tdorssers/thermostat/schematic/AC.sch

## EAGLE design schematic/AC.sch (2024-11-17)

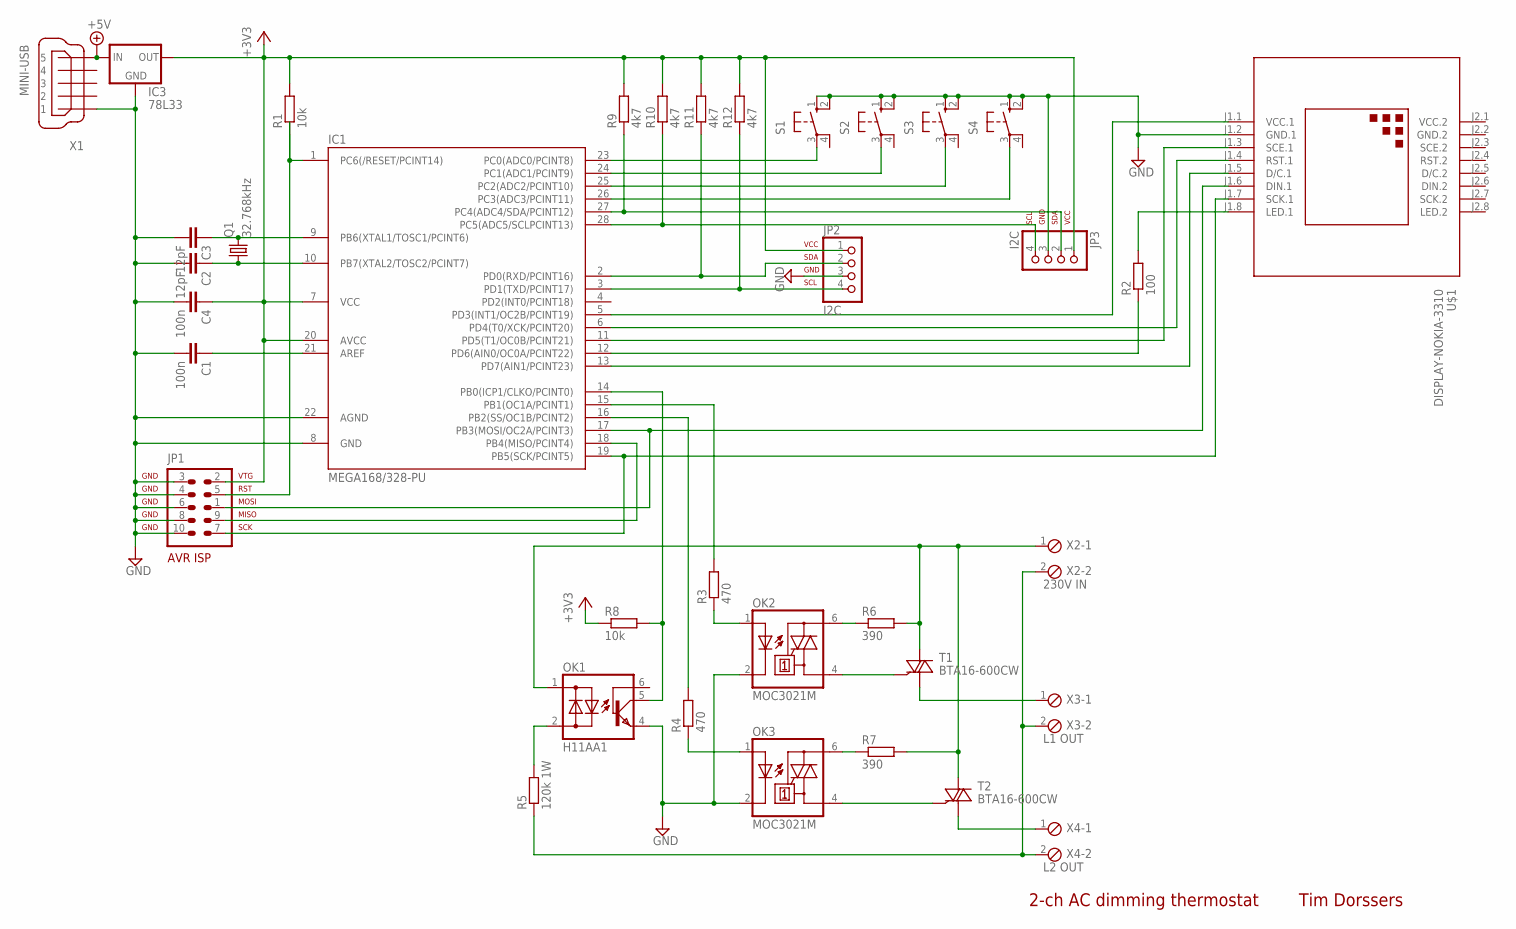
[picture p3: schematic AC.sch]

Parts:
C1, C4: 100n; C025-025X050
C2, C3: 12pF; C025-024X044
IC1: MEGA168/328-PU; DIL28-3
IC3: 78L33; 78LXX
JP1: AVR-ISP-10
JP2, JP3: I2C; 1X04
OK1: H11AA1; DIL06
OK2, OK3: MOC3021M; DIL06
Q1: 32.768kHz; HC49U-V
R1: 10k; 0204/7
R2: 100; 0204/7
R3, R4: 470; 0204/7
R5: 120k 1W; 0207/10
R6, R7: 390; 0204/7
R8: 10k; 0207/10
R9, R10, R11, R12: 4k7; 0204/7
S1, S2, S3, S4: 10-XX; B3F-10XX
T1, T2: BTA16-600CW; TO220BV
U$1: DISPLAY-NOKIA-3310
X1: MINI-USB; 32005-601
X2: 230V IN; 2POL254
X3: L1 OUT; 2POL254
X4: L2 OUT; 2POL254

Connections:
+3V3: C4.1, IC1.7 (VCC), IC1.20 (AVCC), IC3.OUT, JP1.2, JP2.1, JP3.1, R1.2, R8.1, R9.2, R10.2, R11.2, R12.2
+5V: IC3.IN, X1.5
GND: C1.2, C2.2, C3.2, C4.2, IC1.8 (GND), IC1.22 (AGND), IC3.GND, JP1.3, JP1.4, JP1.6, JP1.8, JP1.10, JP2.3, JP3.3, OK1.4 (E), OK2.2 (C), OK3.2 (C), S1.1 (S), S1.2 (S1), S2.1 (S), S2.2 (S1), S3.1 (S), S3.2 (S1), S4.1 (S), S4.2 (S1), U$1.J1.2 (GND.1), X1.1
unnamed: OK1.2 (AC2), R5.2
unnamed: R2.2, U$1.J1.8 (LED.1)
unnamed: IC1.18 (PB4(MISO/PCINT4)), JP1.9
unnamed: IC1.17 (PB3(MOSI/OC2A/PCINT3)), JP1.1, U$1.J1.6 (DIN.1)
unnamed: OK1.1 (AC1), R6.2, R7.2, T1.T2 (A2), T2.T2 (A2), X2.1
unnamed: R5.1, X2.2, X3.2, X4.2
unnamed: IC1.13 (PD7(AIN1/PCINT23)), U$1.J1.5 (D/C.1)
unnamed: IC1.6 (PD4(T0/XCK/PCINT20)), U$1.J1.4 (RST.1)
unnamed: IC1.11 (PD5(T1/OC0B/PCINT21)), U$1.J1.3 (SCE.1)
unnamed: IC1.14 (PB0(ICP1/CLKO/PCINT0)), OK1.5 (C), R8.2
unnamed: IC1.12 (PD6(AIN0/OC0A/PCINT22)), R2.1
unnamed: IC1.23 (PC0(ADC0/PCINT8)), S1.3
unnamed: IC1.24 (PC1(ADC1/PCINT9)), S2.3
unnamed: IC1.2 (PD0(RXD/PCINT16)), JP2.2, R11.1
unnamed: IC1.3 (PD1(TXD/PCINT17)), JP2.4, R12.1
unnamed: IC1.25 (PC2(ADC2/PCINT10)), S3.3
unnamed: IC1.26 (PC3(ADC3/PCINT11)), S4.3
unnamed: IC1.1 (PC6(/RESET/PCINT14)), JP1.5, R1.1
unnamed: C3.1, IC1.9 (PB6(XTAL1/TOSC1/PCINT6)), Q1.2
unnamed: C2.1, IC1.10 (PB7(XTAL2/TOSC2/PCINT7)), Q1.1
unnamed: C1.1, IC1.21 (AREF)
unnamed: IC1.15 (PB1(OC1A/PCINT1)), R3.2
unnamed: OK2.1 (A), R3.1
unnamed: IC1.16 (PB2(SS/OC1B/PCINT2)), R4.2
unnamed: OK3.1 (A), R4.1
unnamed: T2.T1 (A1), X4.1
unnamed: IC1.27 (PC4(ADC4/SDA/PCINT12)), JP3.2, R9.1
unnamed: OK2.6 (A2), R6.1
unnamed: OK3.6 (A2), R7.1
unnamed: OK2.4 (A1), T1.G
unnamed: OK3.4 (A1), T2.G
unnamed: T1.T1 (A1), X3.1
unnamed: IC1.28 (PC5(ADC5/SCLPCINT13)), JP3.4, R10.1
unnamed: IC1.5 (PD3(INT1/OC2B/PCINT19)), U$1.J1.1 (VCC.1)
unnamed: IC1.19 (PB5(SCK/PCINT5)), JP1.7, U$1.J1.7 (SCK.1)

Notes on the sheet:
Tim Dorssers
2-ch AC dimming thermostat
VCC SDA GND SCL
SCL GND SDA VCC
